Labs-Aetheron/Novexa/Documents/illustrations/Body/BotFrontImage1.jpg

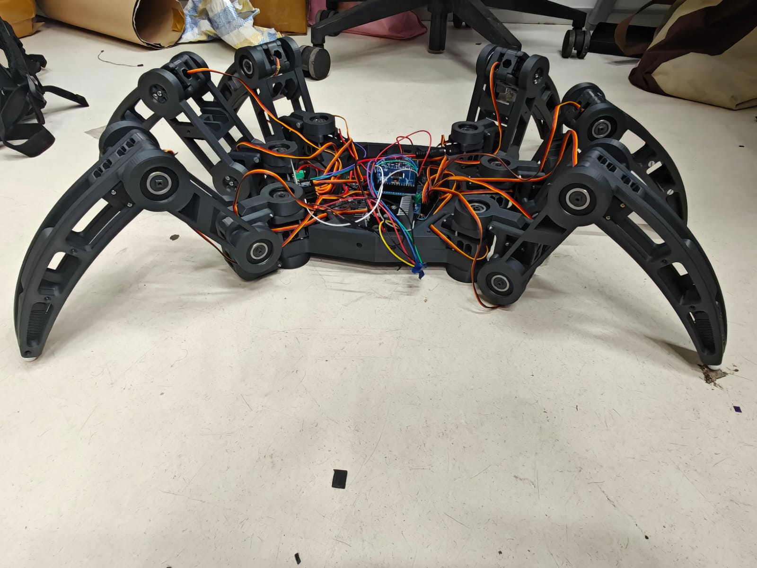
Documents/illustrations/Body/BotFrontImage1.jpg
