Labs-Aetheron/Novexa/Documents/BlockDiagram.jpg

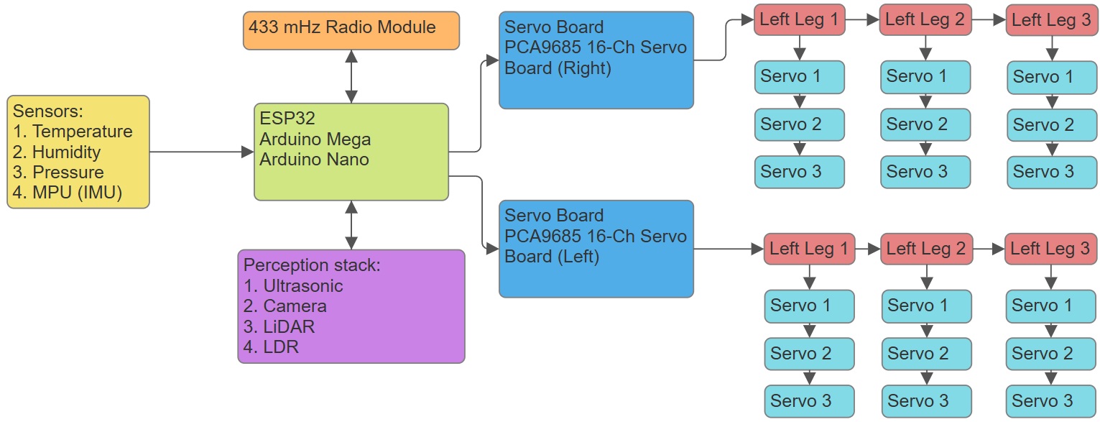
Documents/BlockDiagram.jpg
