Labs-Aetheron/Novexa/Documents/3D_Sketch.docx

1. Battery level Indicator:   Properties:

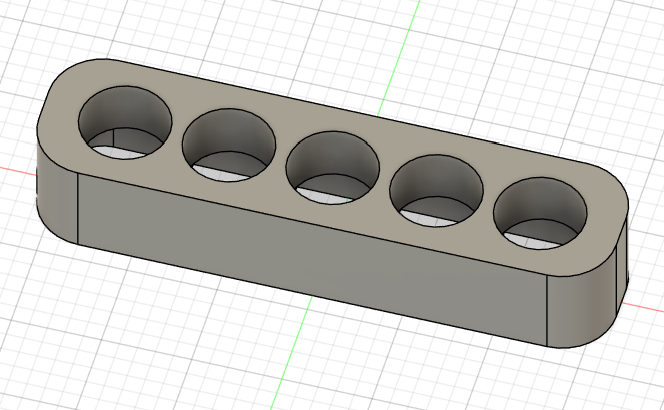
[picture p15: figure]
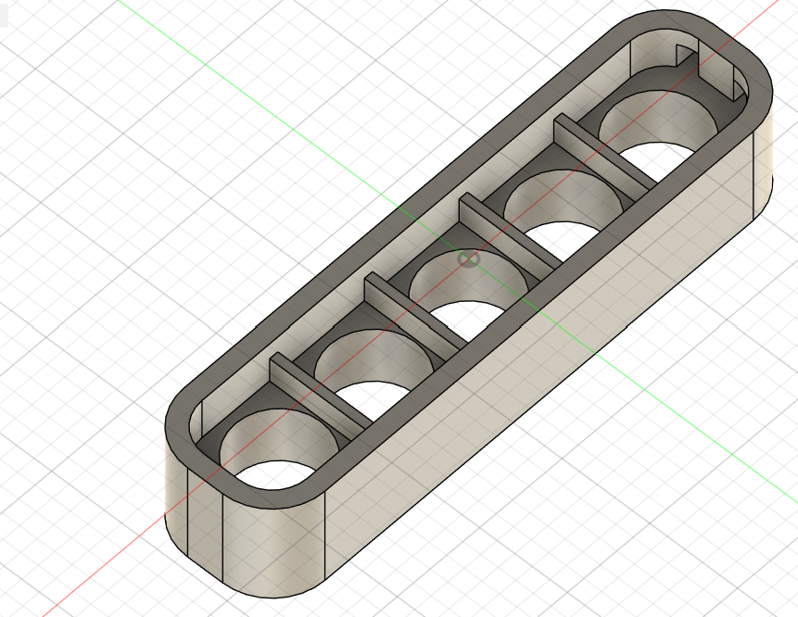
[picture p16: figure]
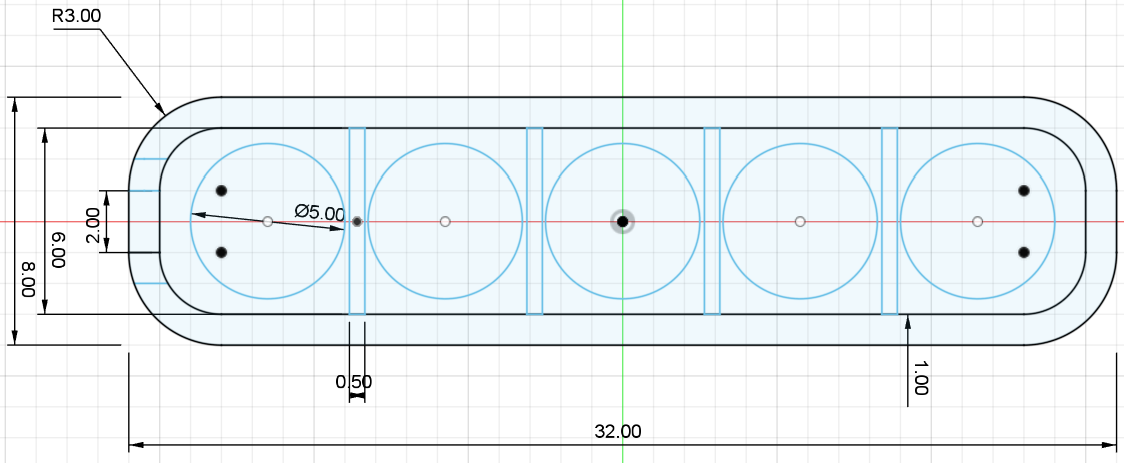
[picture p17: figure]

Area 1271.807 mm^2

Density 0.008 g / mm^3

Mass 5.648 g

Volume 719.527 mm^3

Bounding Box

Length 32.00 mm

Width 8.00 mm

Height 6.00 mm

2. 2S Battery Holder:   properties: Area 10756.48 mm^2

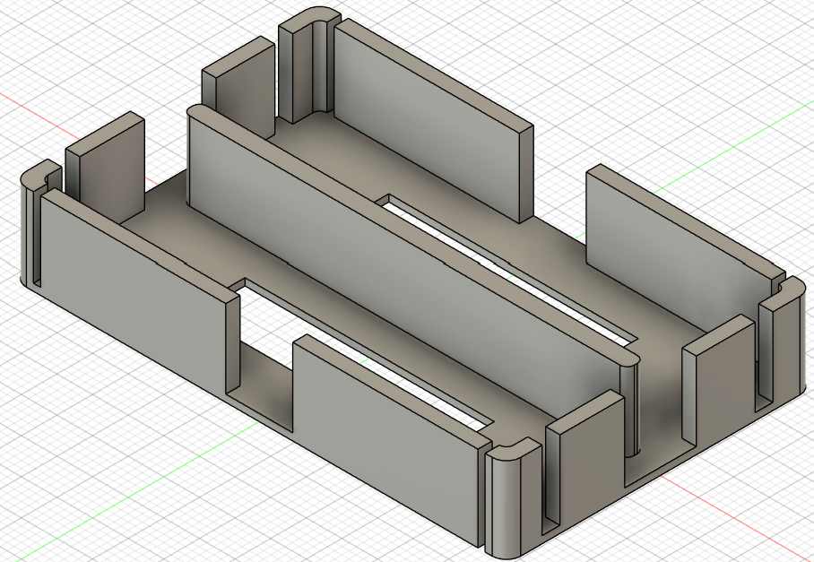
[picture p18: figure]
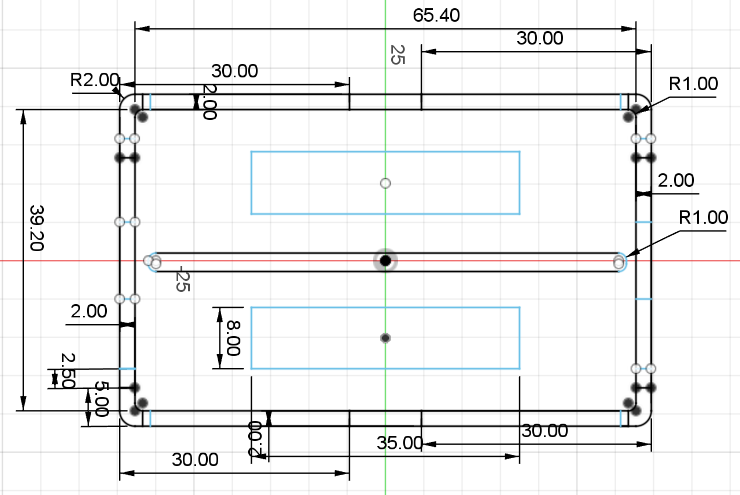
[picture p19: figure]

Mass 60.146 g

Volume 7661.88 mm^3

Bounding Box

Length 69.40 mm

Width 43.20 mm

Height 12.00 mm

3. Tibia Left/ Femur Right

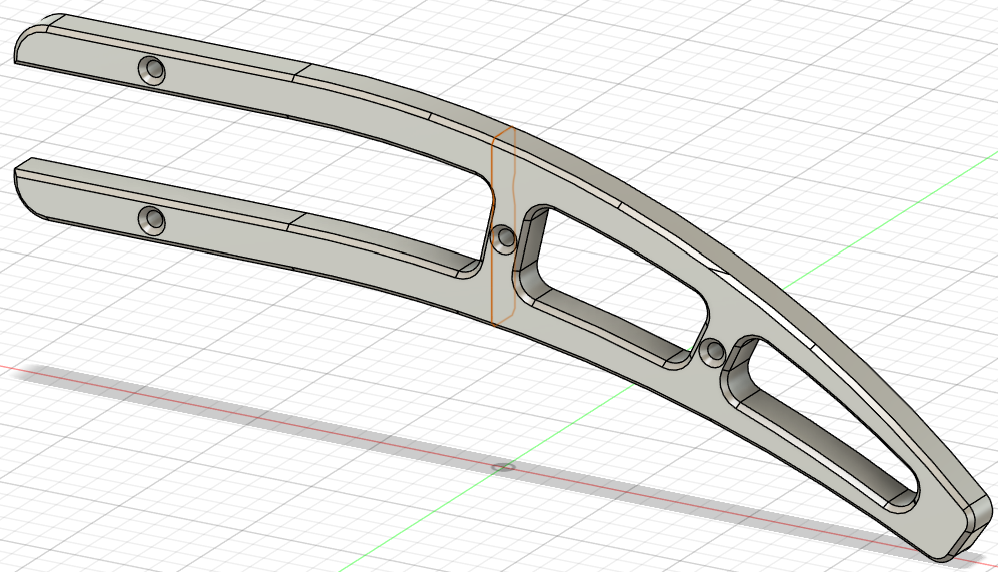
[picture p20: figure]
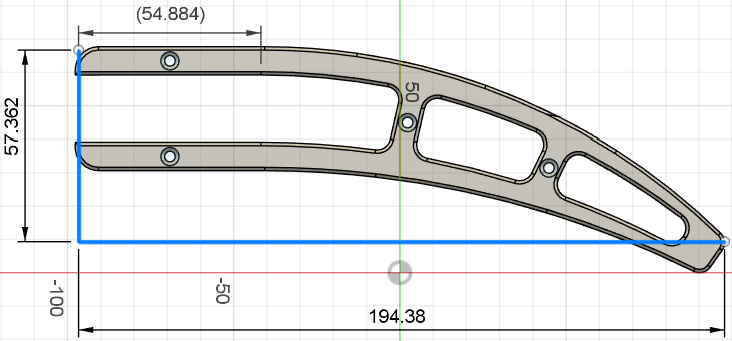
[picture p21: figure]

Properties:

Area 13073.055 mm^2

Mass 16.1747 g

Volume 26464.546 mm^3

Bounding Box

Length 195.402 mm

Width 8.30 mm

Height 67.695 mm

4. Tibia Support:

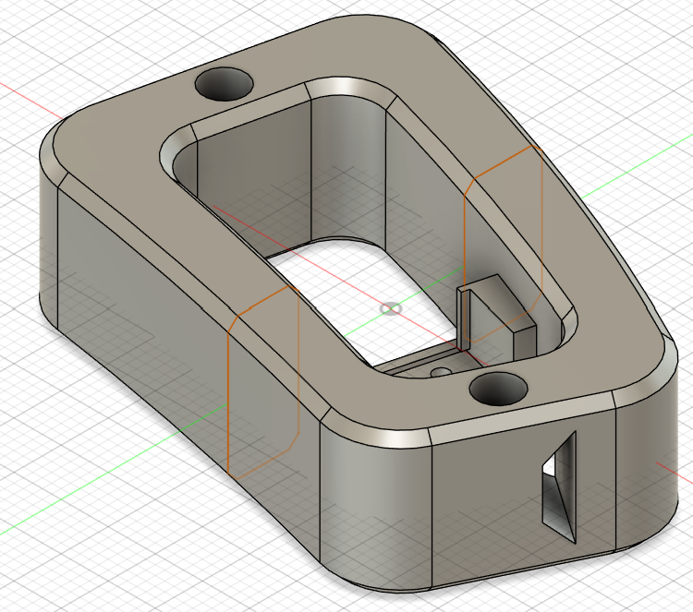
[picture p22: figure]
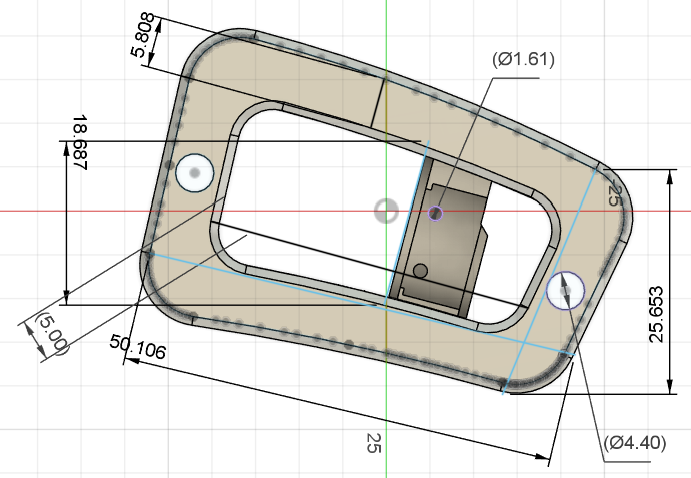
[picture p23: figure]

5. Tibia Suspension Left/Right:

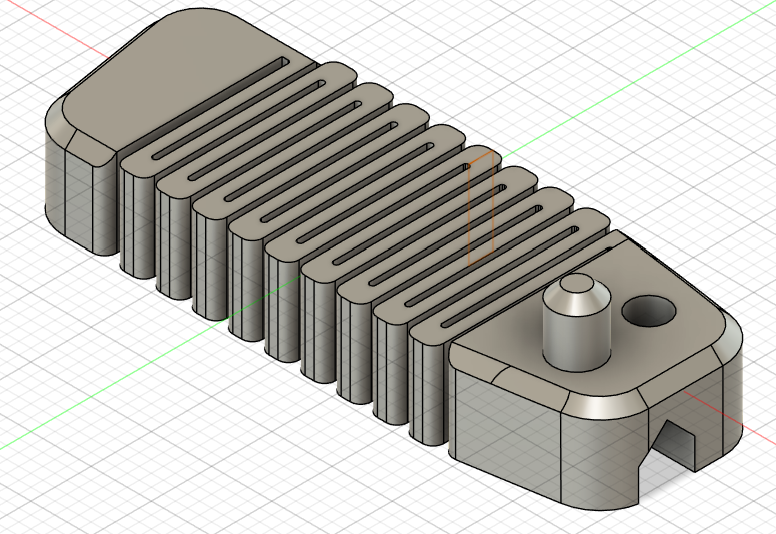
[picture p24: figure]
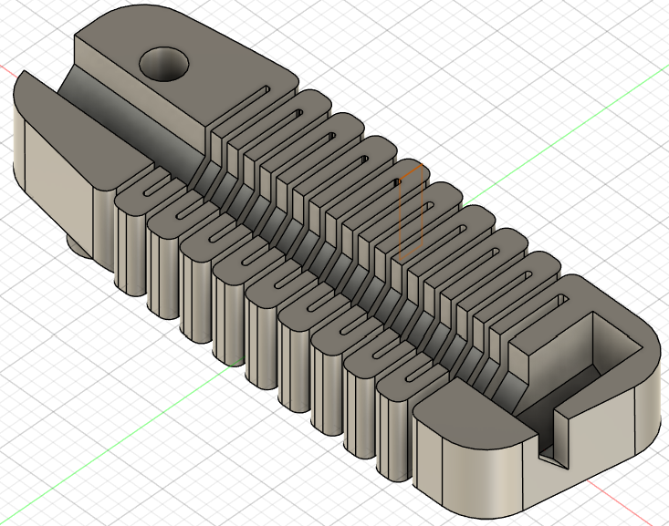
[picture p25: figure]
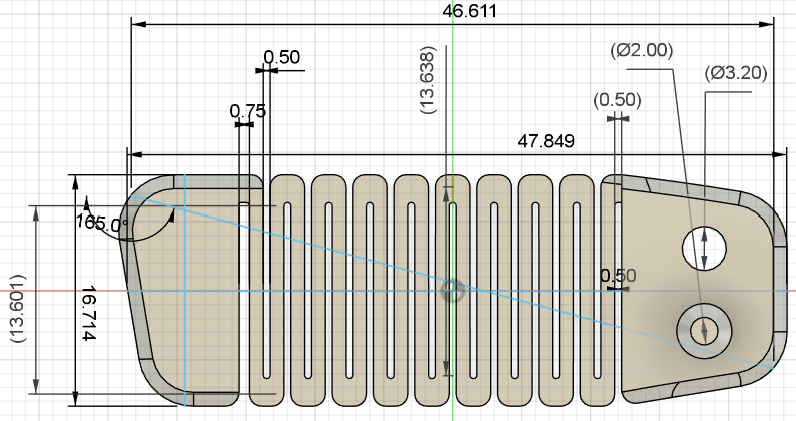
[picture p26: figure]

6. Tibia Shaft:

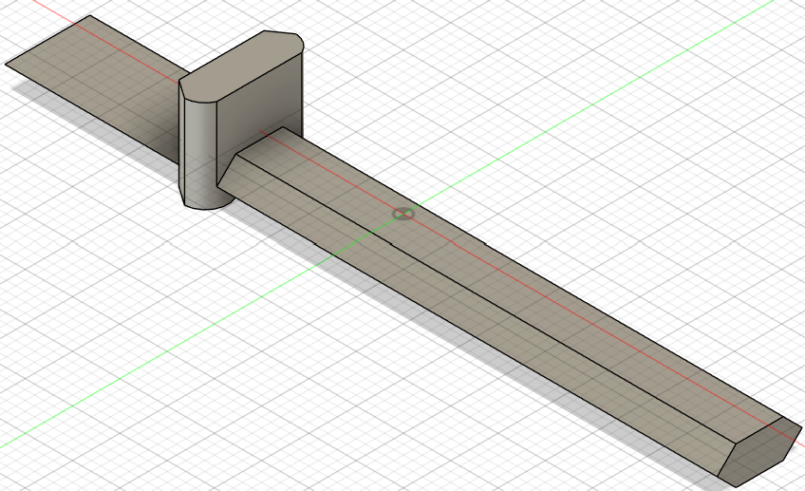
[picture p27: figure]
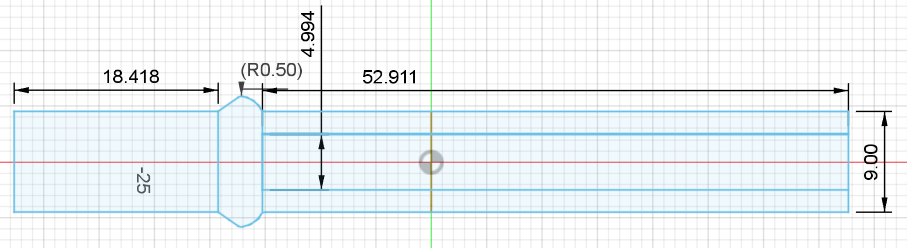
[picture p28: figure]

7. Tibia Tip:

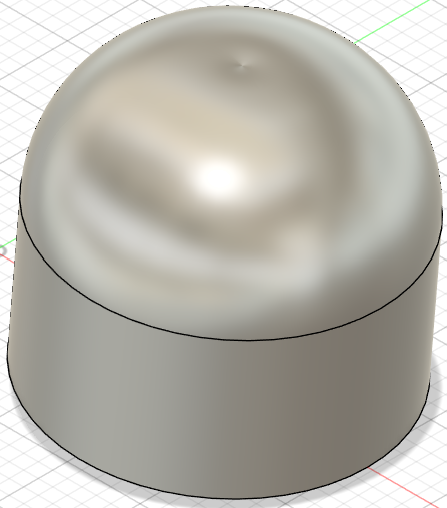
[picture p29: figure]
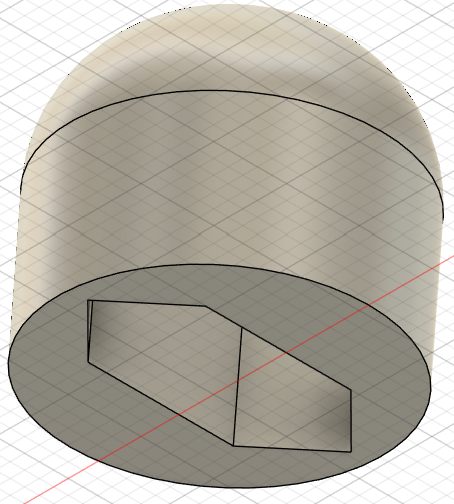
[picture p30: figure]
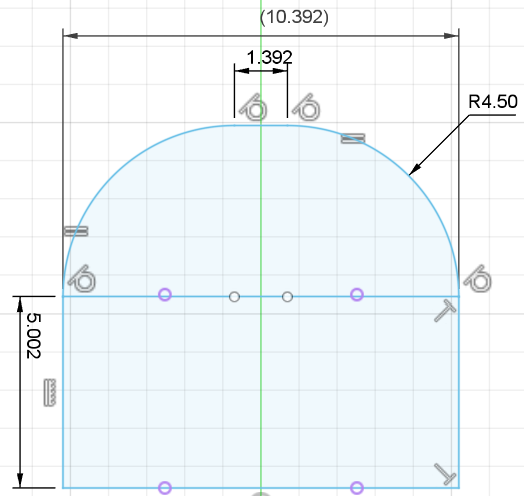
[picture p31: figure]

8. Femur Horn:

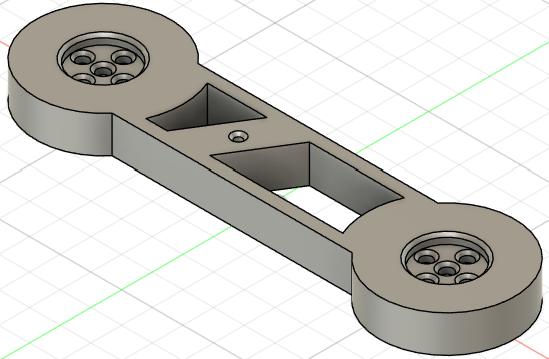
[picture p32: figure]
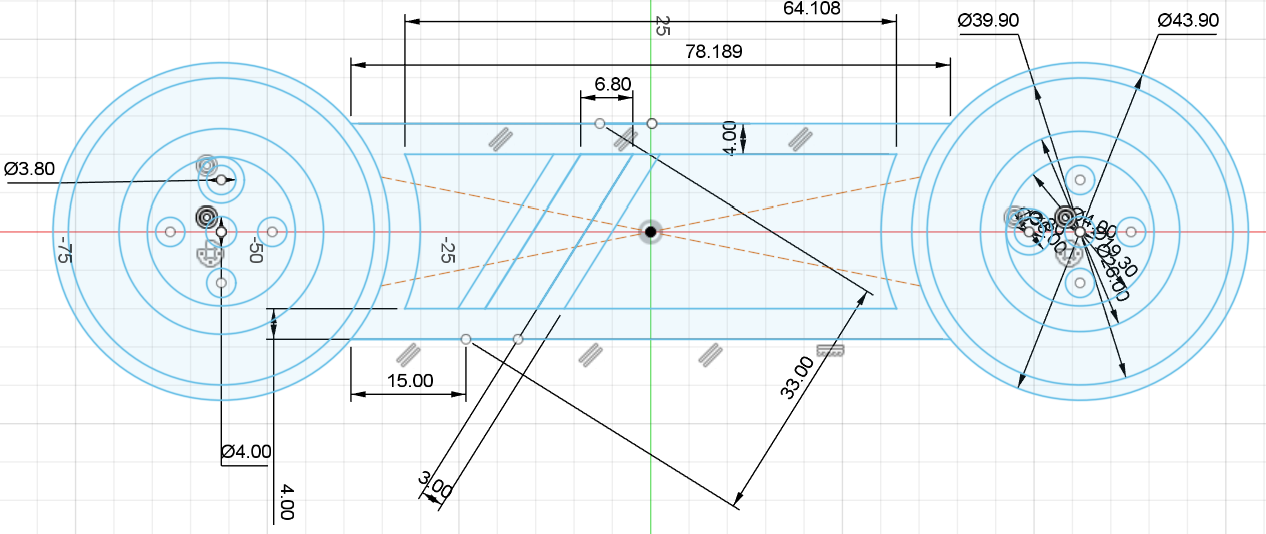
[picture p33: figure]

9. Femur Bearing:

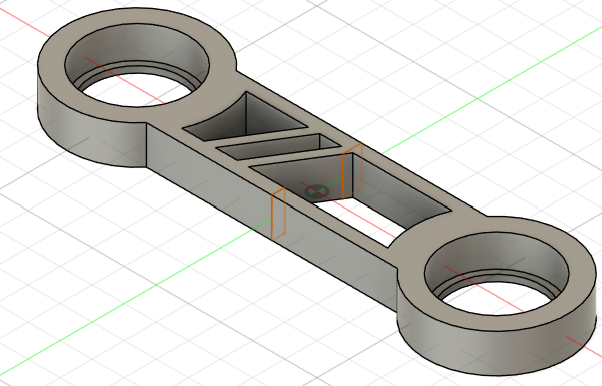
[picture p34: figure]
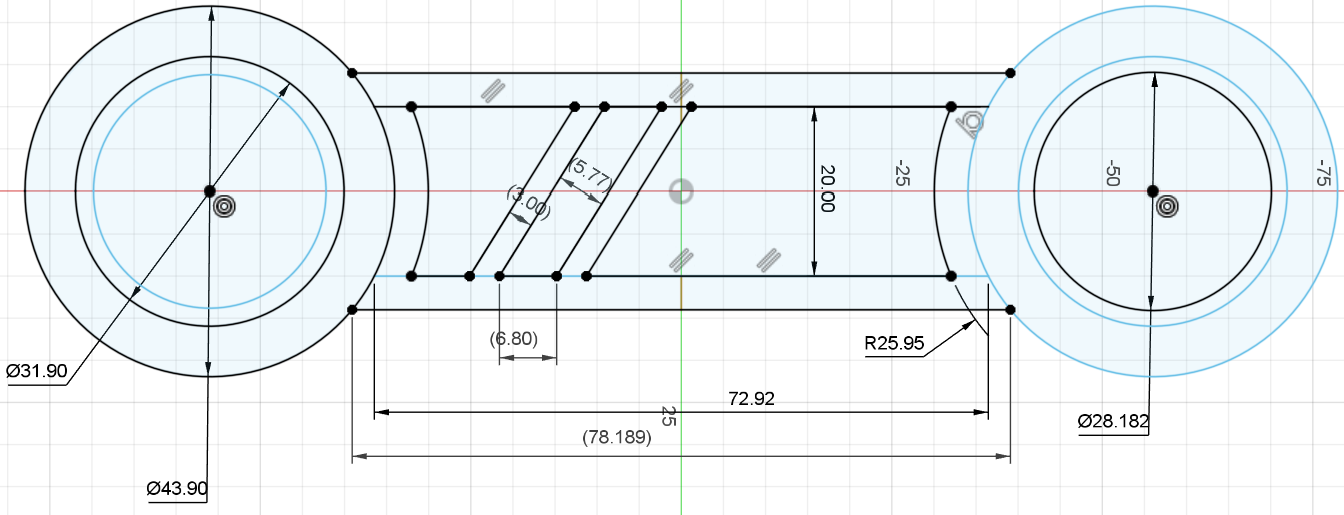
[picture p35: figure]

10. Femur Support:

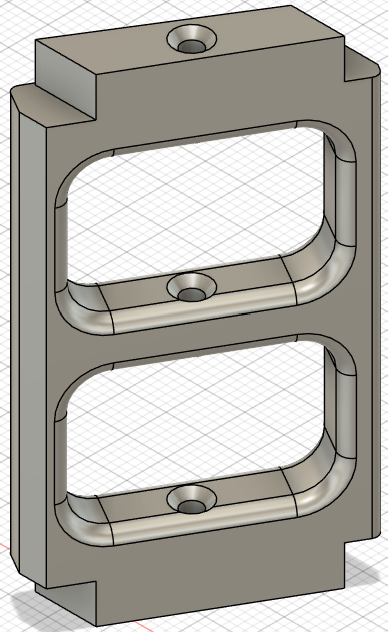
[picture p36: figure]
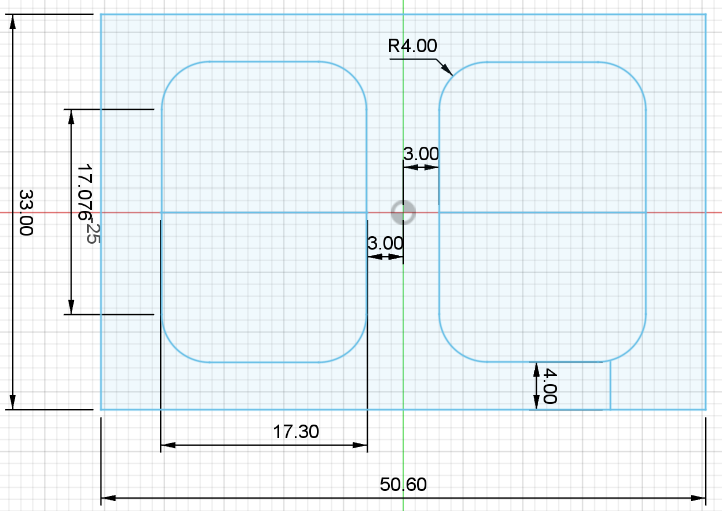
[picture p37: figure]

11. Coxa Horn/Bearing Side:

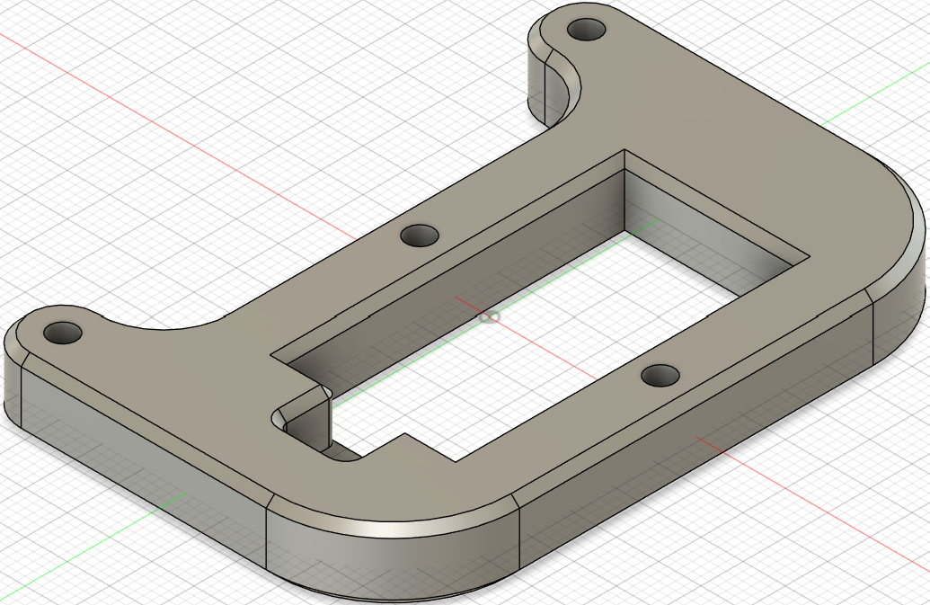
[picture p38: figure]
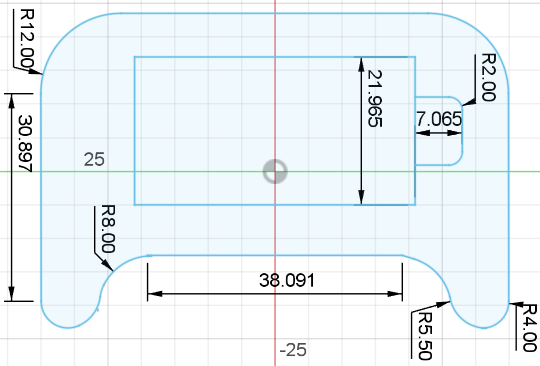
[picture p39: figure]

12. Coxa Horn Connector:

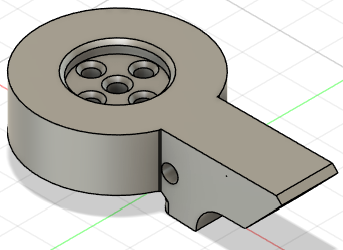
[picture p40: figure]
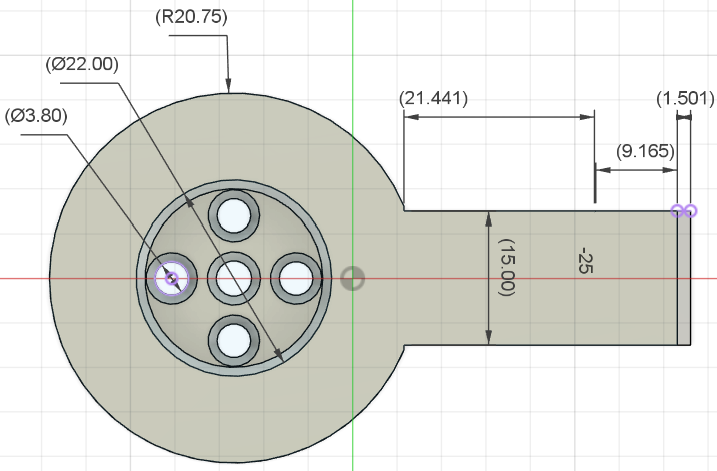
[picture p41: figure]

13. Coxa Bearing Connector:

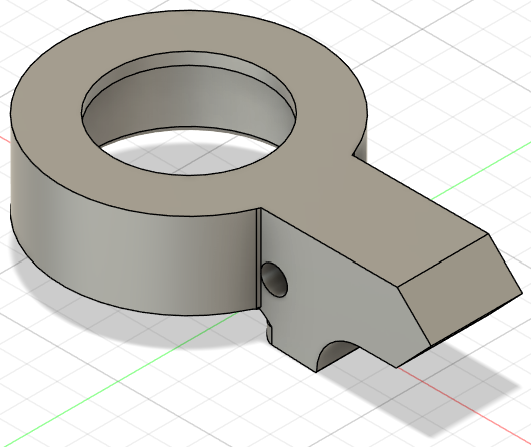
[picture p42: figure]
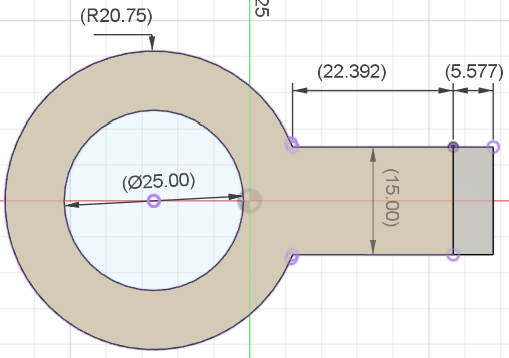
[picture p43: figure]

  a. Body Bottom Plate:
14. Body Mid:
15. Body Top:
