Labs-Aetheron/Novexa/Documents/illustrations/Body/BodyWithArms2.png

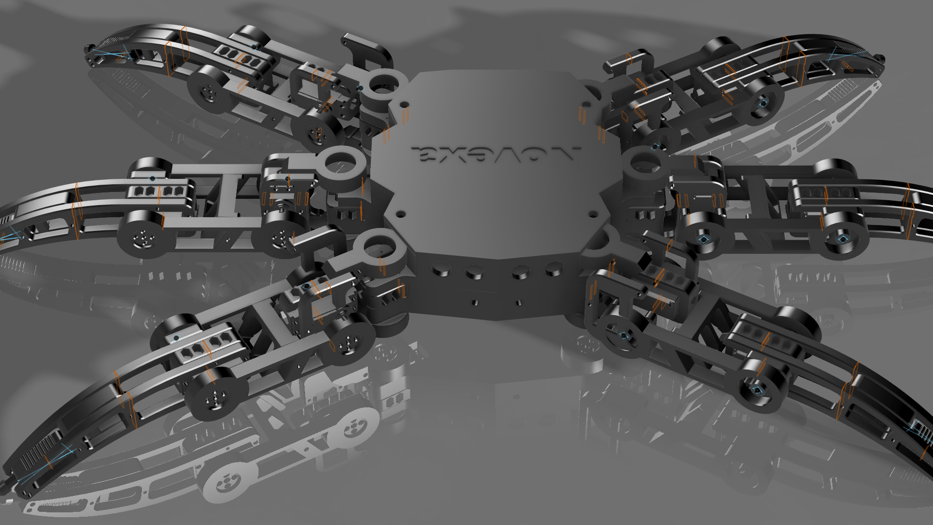
Documents/illustrations/Body/BodyWithArms2.png
