Labs-Aetheron/Novexa/Documents/illustrations/Body/BodyWithArms.jpg

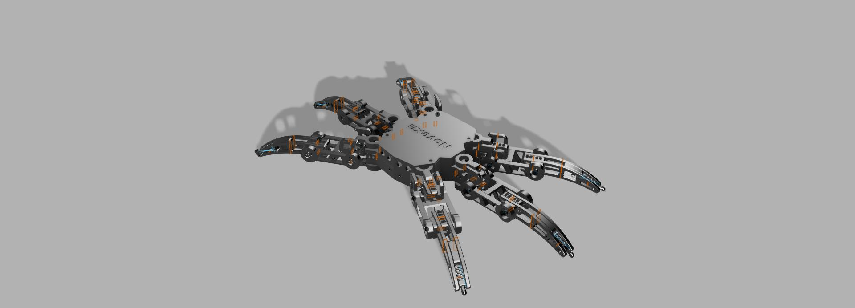
Documents/illustrations/Body/BodyWithArms.jpg
