Labs-Aetheron/Novexa/Documents/illustrations/Body/BodyWithArms.png

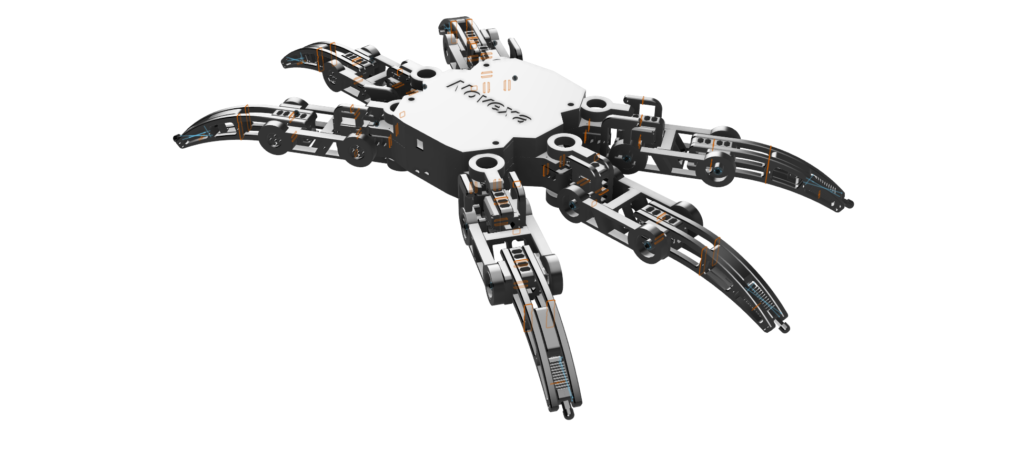
Documents/illustrations/Body/BodyWithArms.png
