Labs-Aetheron/Novexa/Documents/illustrations/Body/Display for Public Visit.png

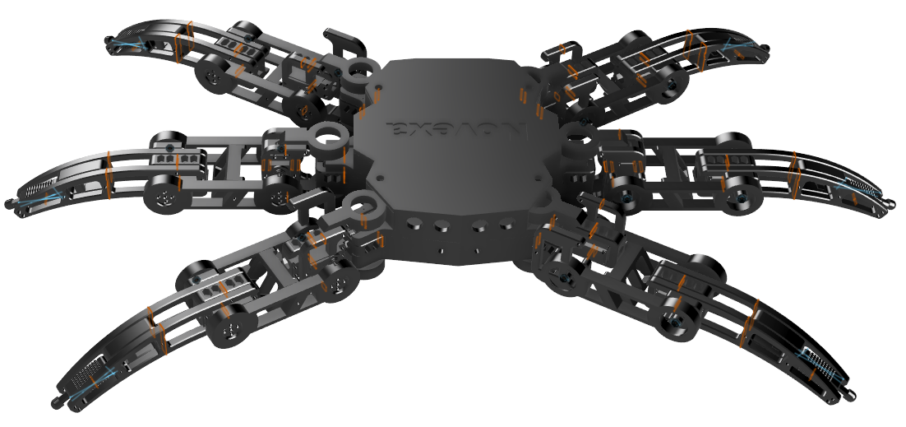
Documents/illustrations/Body/Display for Public Visit.png
