Labs-Aetheron/Novexa/Documents/illustrations/BodyWithArms.png

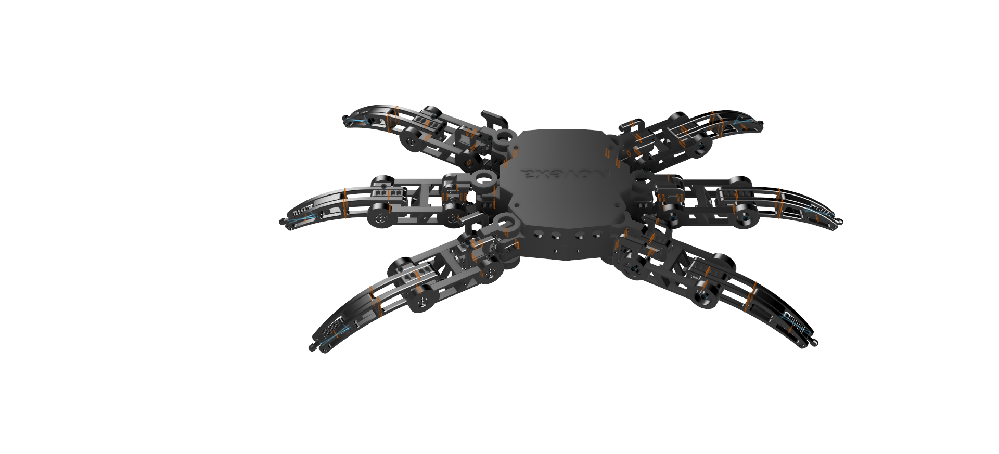
Documents/illustrations/BodyWithArms.png
