Labs-Aetheron/Novexa/Documents/Component_List.xlsx

Sheet: Robu.in Purchases
Sr | Component | Qty | Unit Price (₹) | Specification / Model | Function / Requirement | Suitability / Comment | Total (₹)
1 | RF Transmitter Receiver Module 433MHz Wireless Link Kit For Arduino | 1 | ₹84.00 | 433 MHz Link Kit | Remote control communication | Works perfectly for basic wireless rover control | ₹84.00
2 | 15CM SMA Female to IPEX4 Connector Cable 11mm RG0.81 | 2 | ₹94.00 | RG0.81, 15 cm | Antenna pigtails for TX/RX | Proper impedance for 433 MHz RF; one for TX, one for RX | ₹188.00
3 | 2S 5A 8.4V 18650 Lithium Battery Charger Board Protection Module | 1 | ₹54.00 | 2S Charger (may include protection) | Charge logic 2S pack | OK; verify overlap with 2S BMS | ₹54.00
4 | PDC004-PD PD Decoy Module 12V | 1 | ₹117.00 | USB‑C PD trigger (12 V) | Single‑port charging hub | Excellent choice, 60 W PD sink | ₹117.00
5 | 4S 16.8V 2A 18650 Lithium Battery Charger Module Type C | 1 | ₹117.00 | 4S charger | Charge servo 4S pack | Check VIN range (5–12 V) | ₹117.00
6 | 4 Series 40A 18650 Lithium Battery Protection Board | 1 | ₹138.00 | 4S 14.8–16.8 V with balance | Servo pack protection | Correct for high-current pack | ₹138.00
7 | 2S 10A 18650 Battery Protection Board | 1 | ₹95.00 | 2S 7.4–8.4 V | Logic pack protection | Suitable for Arduino/sensors | ₹95.00
8 | Littelfuse MAXI 0299040 40 A Fuse | 2 | ₹90.00 | MAXI 299, 32 V | Main 4S line fuse | Industrial-grade protection | ₹180.00
9 | 5×20 mm Glass Fuse 10 A | 5 | ₹6.00 | Glass Fuse 10 A | Secondary protection (logic/charger lines) | Simple protection | ₹30.00
10 | Toggle Switch KNX‑209 | 1 | ₹52.00 | SPST | Remote power | Use in handheld remote | ₹52.00
11 | KCD2‑201 DPST Rocker Switch (ON‑OFF) | 1 | ₹68.00 | DPST 4‑pin | Master switch (4S + 2S) | Ideal dual-battery control | ₹68.00
12 | Mini MP1584 DC‑DC 3 A Adjustable Buck Module | 2 | ₹39.00 | MP1584 3 A | 5 V logic rail | Efficient small buck for Arduino; one spare | ₹78.00
13 | 200 W 20 A CC/CV Buck Converter | 2 | ₹369.00 | 6–40 V → adj; CC/CV | 5.8 V servo rails (two bucks) | Good current & thermal headroom | ₹738.00
14 | 4700 µF 50 V Electrolytic Capacitor | 4 | ₹53.00 | 50 V bulk cap | Servo rail surge buffer | Prevents voltage dips when servos spike | ₹212.00
15 | 0.1 µF Ceramic Capacitor SMD 1206 | 8 | ₹1.38 | 100 nF | HF decoupling at buck outputs | Filters switching noise | ₹11.04
16 | SMBJ6.8CA TVS Diode | 2 | ₹6.00 | 6.8 V bidirectional 600 W | Clamp servo rail spikes | Protects buck from back-EMF | ₹12.00
17 | Rubycon 220 µF 10 V (10YXJ220M5X11) | 6 | ₹7.00 | Low‑ESR 10 V | Logic buck smoothing | Top quality, high ripple tolerance | ₹42.00
18 | Male‑Male Jumper Wires 20 cm (40 pcs) | 1 | ₹42.00 | Dupont 20 cm | Signals / prototyping | Useful for testing | ₹42.00
19 | Male‑Female Jumper Wires 10 cm (40 pcs) | 1 | ₹35.00 | Dupont 10 cm | Logic interconnect | Standard Arduino links | ₹35.00
20 | Amass XT60I‑F.G.O Female Connector | 4 | ₹61.00 | XT60 30 A+ | Battery/rail connectors | Reliable gold‑plated terminals | ₹244.00
21 | Nickel Strip 0.1 × 4 × 100 mm (50 pcs) | 1 | ₹153.00 | Pure nickel | Cell interconnects | Optional; helps in pack build | ₹153.00
Total: |  | 48 | ₹1681.38 |  |  |  | ₹2690.04

Sheet: Lamington Road
Sr | Component | Qty | Unit Price (₹) | Specification / Model | Function / Requirement | Suitability / Comment | Total (₹)
1 | MG995 Servo Motor | 20 | ₹225.00 | ≈9 kg·cm | Actuators (18 used + 2 spare) | Perfect for hexapod legs | ₹4500.00
2 | Joystick Module | 3 | ₹40.00 | Analog dual‑axis | Remote input | Ideal for handheld remote | ₹120.00
3 | PCA9685 16‑Ch Servo Board | 2 | ₹275.00 | 16‑ch PWM | Servo signal driver | Required (2 boards total) | ₹550.00
4 | Arduino Mega 2560 | 1 | ₹1000.00 | Main MCU | Robot control | Excellent for many I/O | ₹1000.00
5 | Arduino Nano | 1 | ₹250.00 | ATmega328 | Remote / aux control | Good secondary MCU | ₹250.00
6 | MPU6050 IMU | 1 | ₹175.00 | 6‑axis | Stability sensing | Good for balance | ₹175.00
7 | Arduino Nano USB Cable | 1 | ₹20.00 | USB | Programming Nano | Required connectivity | ₹20.00
8 | Resistors (assorted) | 12 | ₹1.00 | ¼ W | LEDs / dividers | Basic electronics need | ₹12.00
9 | Switches (misc) | 2 | ₹5.00 | Mini toggle | Misc toggling | Standard | ₹10.00
10 | 18650 Li‑ion Cells | 8 | ₹65.00 | 3.7 V 2600 mAh | Batteries for packs | Right capacity class | ₹520.00
11 | Wire stripper | 1 | ₹450.00 | Tool | Assembly | Essential tool | ₹450.00
12 | Screw & Nut pack (50 pcs) | 1 | ₹140.00 | Assortment | Frame and mounts | Useful hardware | ₹140.00
13 | Soldering wire | 1 | ₹120.00 | Flux core | Assembly | Required for wiring | ₹120.00
14 | Bearings | 18 | ₹35.00 | 32.00 mm | To make the arm frictionless | 32 mm bearings reduce friction in limb joints, improving motion precision and protecting servos for longer life. | ₹630.00
15 | Copper wire (4 m) | 1 | ₹40.00 | Bare copper | Low‑current | Not for high current | ₹40.00
Total: |  | 73 | ₹2841.00 |  |  |  | ₹8537.00

Sheet: Overall Evaluation
Aspect | Comment
Power architecture | Dual-battery (4S servos, 2S logic) with separate bucks; clean, stable; single USB‑C input charges both packs.
Protection | BMS on both packs, main 40 A fuse, logic fuses, bulk caps + ceramic + TVS; robust against shorts and surges.
Servo supply | Two 20 A CC/CV bucks (one per PCA board) set to ~5.8 V; good thermal headroom with fans.
Logic supply | MP1584 set to 5.00 V; low‑ESR 220 µF + 0.1 µF at output; powers Arduino + PCA logic reliably.
Grounding | Common star ground between servo and logic rails; prevents signal reference issues.
Wiring | Use silicone multi‑strand; correct gauge selection prevents drops/heating; XT60 connectors for reliability.
Charging | PD decoy → 4S & 2S chargers; chargers wired directly to BMS P+/P− via small fuses; master switch OFF when charging.
Scalability | Two rails and PCA stack make expansion easy; spares included (extra MP1584).

Sheet: Summary
Source | Total (₹)
Robu.in | ₹2690.04
Lamington Road | ₹8537.00
Grand Total (Purchased) | ₹11227.04
