Labs-Aetheron/Novexa/Mechanical/Design/Assembly/novexa_assembly_01.step

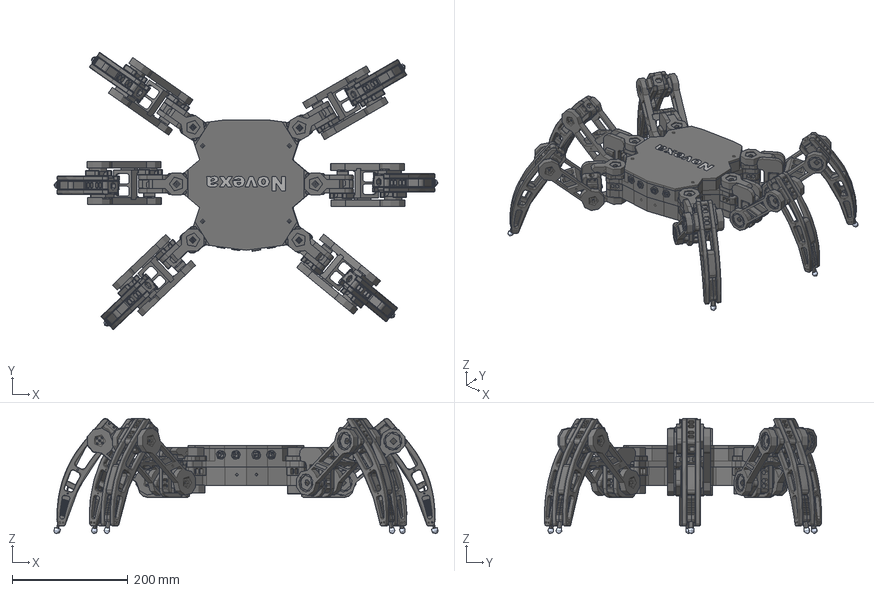
[picture p51: CAD file, 2026-10-25]
Mechanical/Design/Assembly/novexa_assembly_01.step
662.5 x 477.8 x 198.7 mm
ArduinoMega_STEP_AP203
PCB x 2
Case Cover x 4
T-R Case x 4
T-R Core x 4
T-R Terminal x 8
Crystal x 2
90deg_pin x 8
Conn_1X4_case x 2
SOP14_TPK x 4
16-SOIC x 2
