Labs-Aetheron/Novexa/Mechanical/Design/All STLS/BearingMountV3.stl

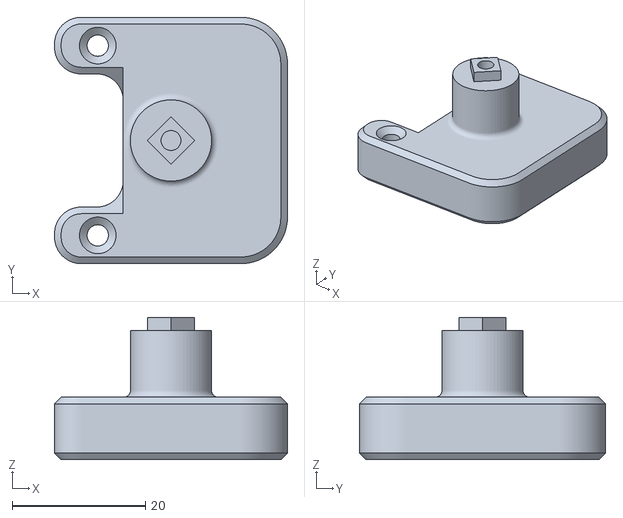
[picture p52: CAD file, 2025-12-05]
Mechanical/Design/All STLS/BearingMountV3.stl
35.0 x 37.0 x 21.4
