Labs-Aetheron/Novexa/Mechanical/Design/All STLS/Print/BilalSabugar_FinalBuildParts_BTechRoboticsFY.3mf

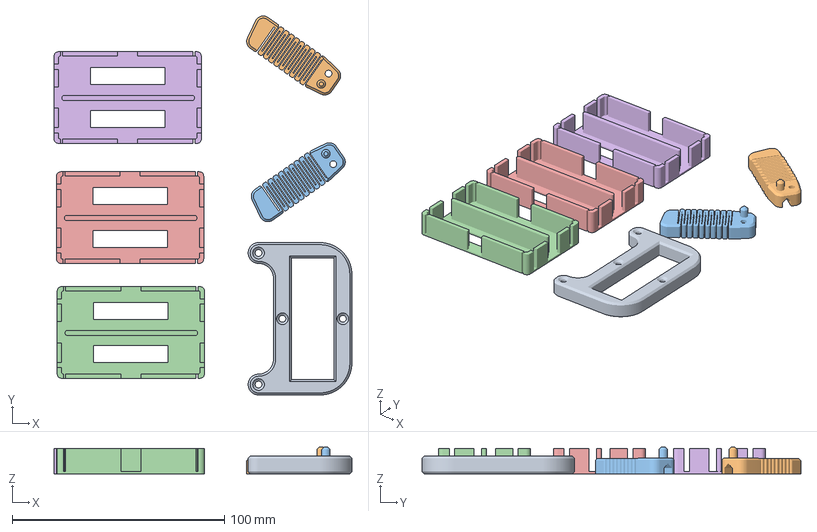
[picture p53: CAD file, 2025-12-05]
Mechanical/Design/All STLS/Print/BilalSabugar_FinalBuildParts_BTechRoboticsFY.3mf
140.4 x 178.6 x 12.5 mm
Coxa Horn Side.stl
Foot Left.stl
Foot Right.stl
2SBatteryHolder.stl x 3
