Labs-Aetheron/Novexa/Mechanical/Design/Cad/BilalSabugar_CrabyyPartsV2_BTechRoboticsFY.stl

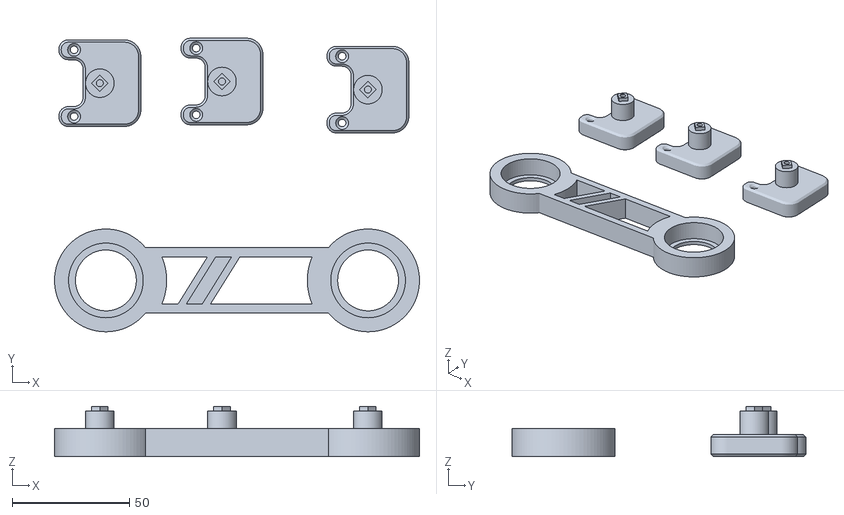
[picture p54: CAD file, 2025-12-05]
Mechanical/Design/Cad/BilalSabugar_CrabyyPartsV2_BTechRoboticsFY.stl
155.9 x 125.4 x 21.4
