Labs-Aetheron/Novexa/Mechanical/Design/All STLS/BottomPlateV2.stl

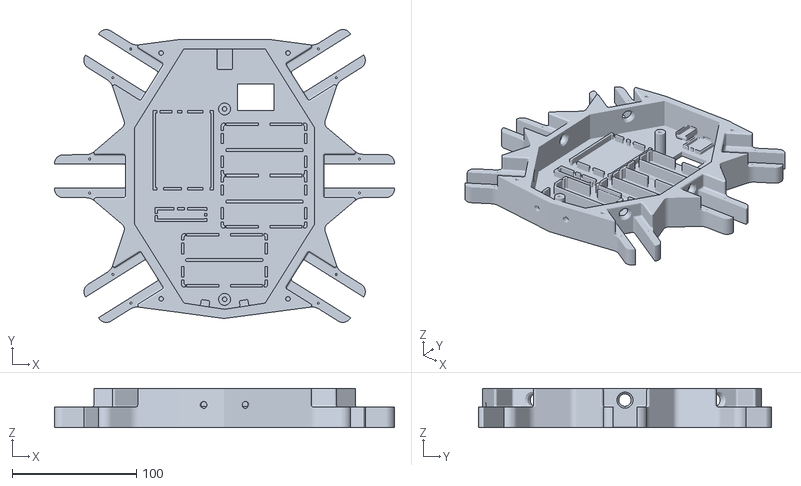
[picture p55: CAD file, 2025-12-05]
Mechanical/Design/All STLS/BottomPlateV2.stl
274.2 x 236.2 x 31.7
