Labs-Aetheron/Novexa/Mechanical/Design/All STLS/Print/BilalSabugar_ServoMount_BTechRoboticsFY.3mf

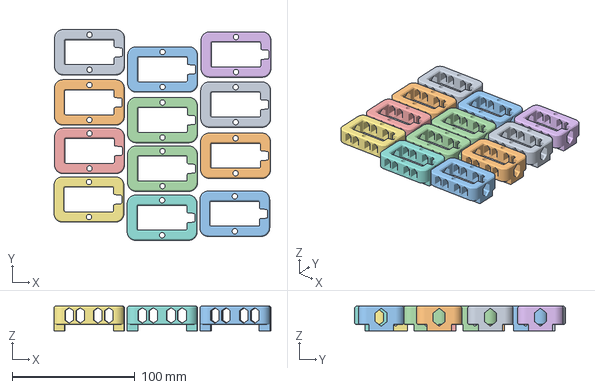
[picture p56: CAD file, 2025-12-05]
Mechanical/Design/All STLS/Print/BilalSabugar_ServoMount_BTechRoboticsFY.3mf
176.8 x 171.8 x 20.0 mm
Servo Mount.stl x 12
