Labs-Aetheron/Novexa/Mechanical/Design/All STLS/BodyCoverV2.stl

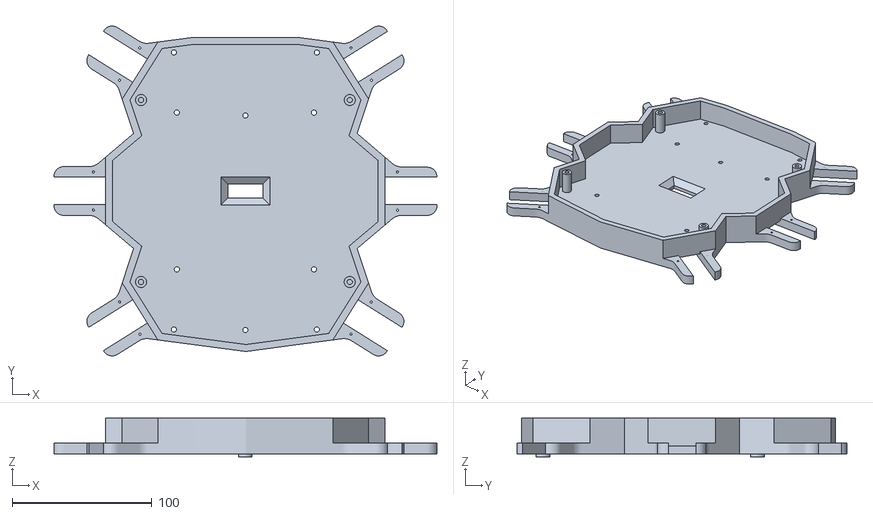
[picture p57: CAD file, 2025-12-05]
Mechanical/Design/All STLS/BodyCoverV2.stl
274.2 x 236.1 x 27.9
