Labs-Aetheron/Novexa/Mechanical/Design/All STLS/Print/BearingMountV2Extras.3mf

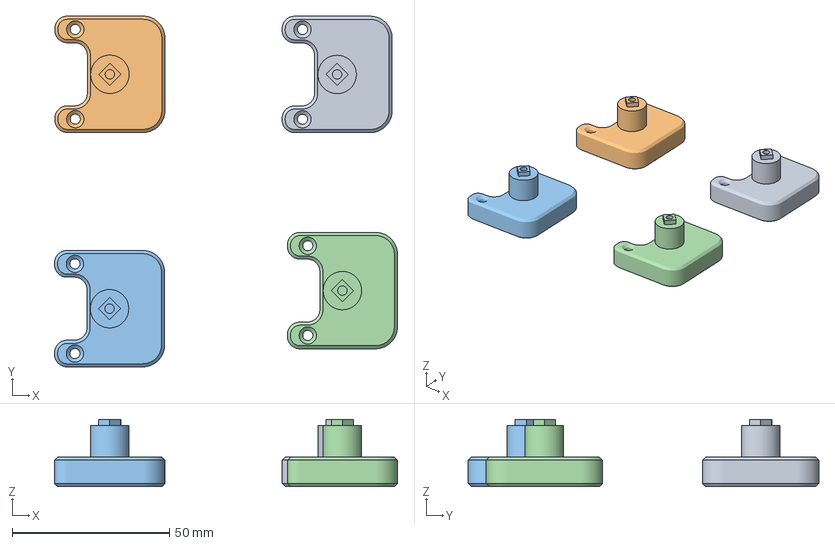
[picture p58: CAD file, 2025-12-05]
Mechanical/Design/All STLS/Print/BearingMountV2Extras.3mf
109.0 x 111.5 x 21.4 mm
BearingMountV2.stl x 4
