Labs-Aetheron/Novexa/Mechanical/Design/Cad/FemurBearingSideV2.stl

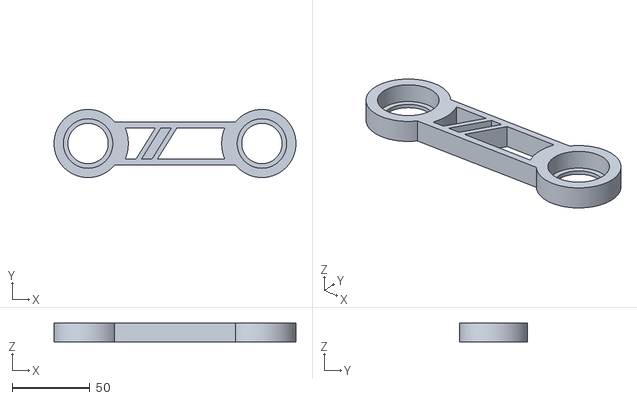
[picture p59: CAD file, 2025-12-05]
Mechanical/Design/Cad/FemurBearingSideV2.stl
155.9 x 43.9 x 12.0
