Labs-Aetheron/Novexa/Mechanical/Design/All STLS/CoxaBearingConnectorV2.stl

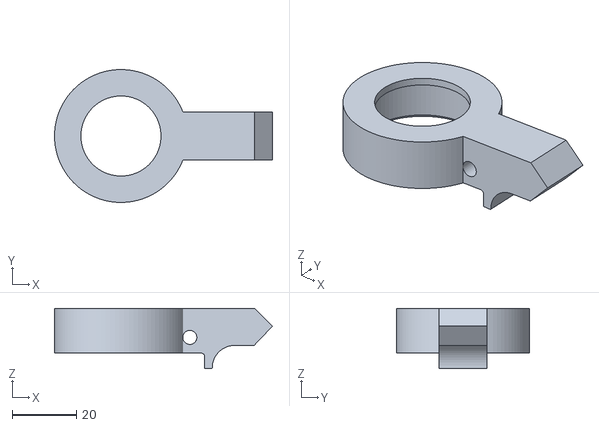
[picture p60: CAD file, 2025-12-05]
Mechanical/Design/All STLS/CoxaBearingConnectorV2.stl
68.1 x 41.5 x 18.8
