Labs-Aetheron/Novexa/Mechanical/Design/All STLS/Print/BilalSabugar_Prototype3_BTechRoboticsFY.3mf

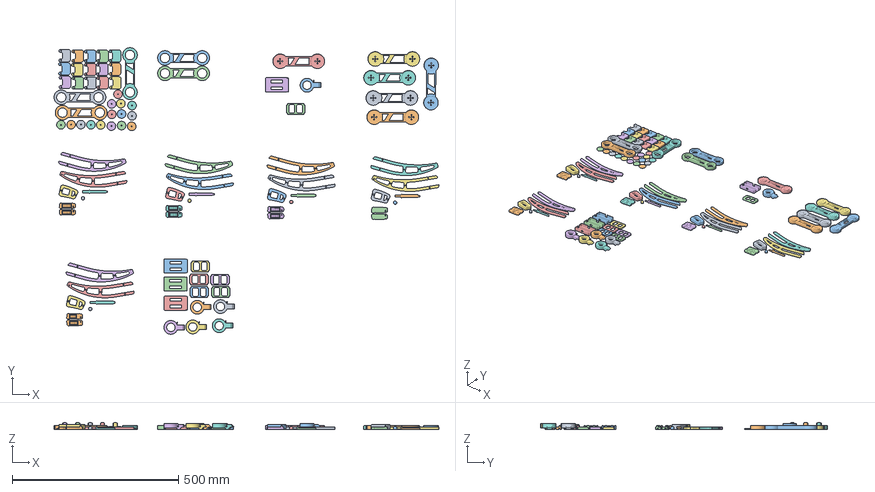
[picture p61: CAD file, 2025-12-05]
Mechanical/Design/All STLS/Print/BilalSabugar_Prototype3_BTechRoboticsFY.3mf
1156.8 x 861.1 x 21.4 mm
BearingMountV2.stl x 15
FemurBearingSideV2.stl x 5
FemurHornSideV2.stl x 6
2SBatteryHolder.stl x 4
Hubcap.stl x 15
CoxaBearingConnectorV2.stl x 6
FemurSupportV2.stl x 6
Tibia Left.stl x 5
Tibia Right.stl x 5
Tibia Support.stl x 5
Foot Shaft.stl x 5
Foot Tip.stl x 5
Foot Left Right.stl x 5
