Labs-Aetheron/Novexa/Mechanical/Design/All STLS/Print/BilalSabugar_PrototypeTwo_BTechRoboticsFY.3mf

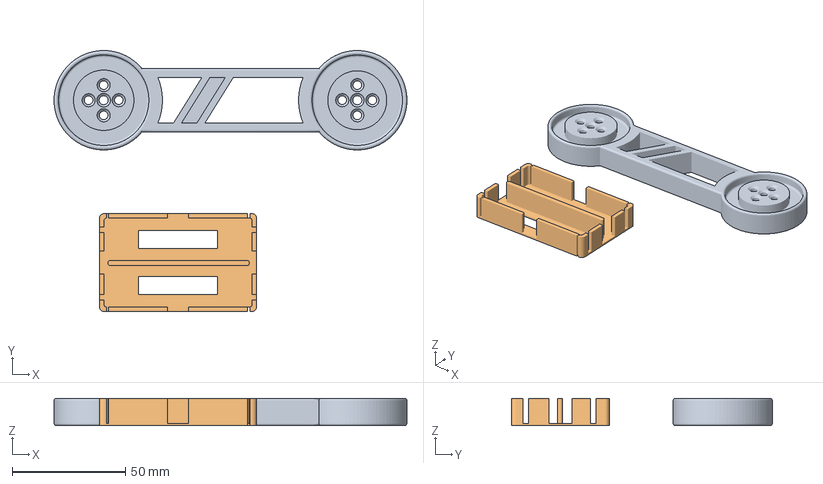
[picture p62: CAD file, 2025-12-05]
Mechanical/Design/All STLS/Print/BilalSabugar_PrototypeTwo_BTechRoboticsFY.3mf
155.9 x 115.2 x 12.0 mm
FemurHornSideV2.stl
2SBatteryHolder.stl
