Labs-Aetheron/Novexa/Mechanical/Design/All STLS/BodyWithArms.stl

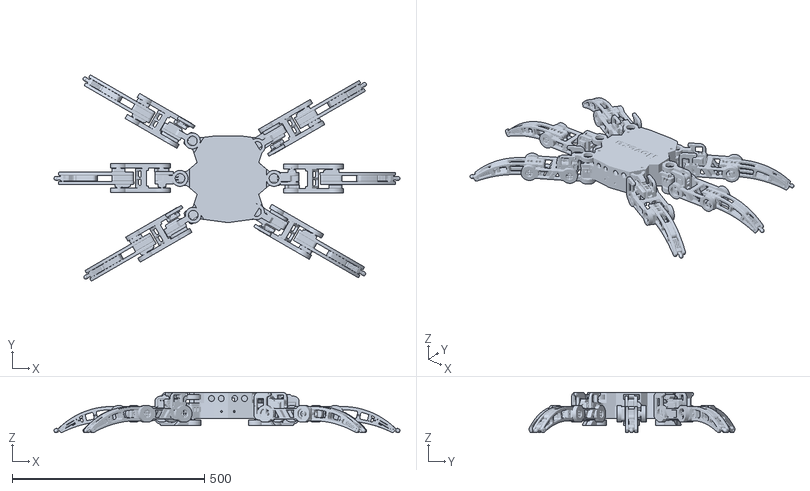
[picture p63: CAD file, 2025-12-05]
Mechanical/Design/All STLS/BodyWithArms.stl
899.2 x 535.6 x 105.2
