Labs-Aetheron/Novexa/Mechanical/Design/All STLS/Print/BilalSabugar_MiddlePlateV2_BTechRoboticsFY.stl

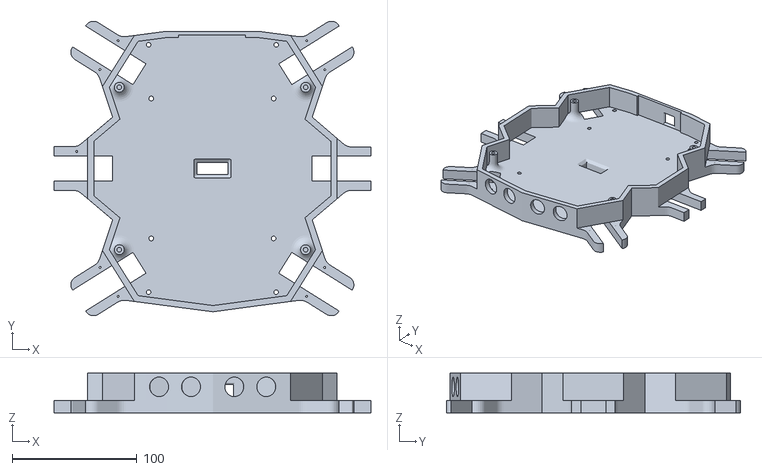
[picture p64: CAD file, 2025-12-05]
Mechanical/Design/All STLS/Print/BilalSabugar_MiddlePlateV2_BTechRoboticsFY.stl
254.2 x 236.1 x 31.9
