Labs-Aetheron/Novexa/Mechanical/Design/All STLS/FemurSupportV2.stl

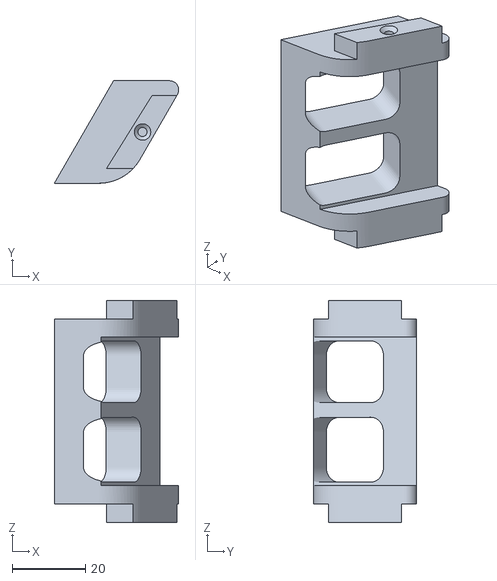
[picture p65: CAD file, 2025-12-05]
Mechanical/Design/All STLS/FemurSupportV2.stl
34.0 x 28.0 x 60.6
