Labs-Aetheron/Novexa/Mechanical/Design/All STLS/Print/BilalSabugar_FemurPrototypeV2_BTechRoboticsFY.3mf

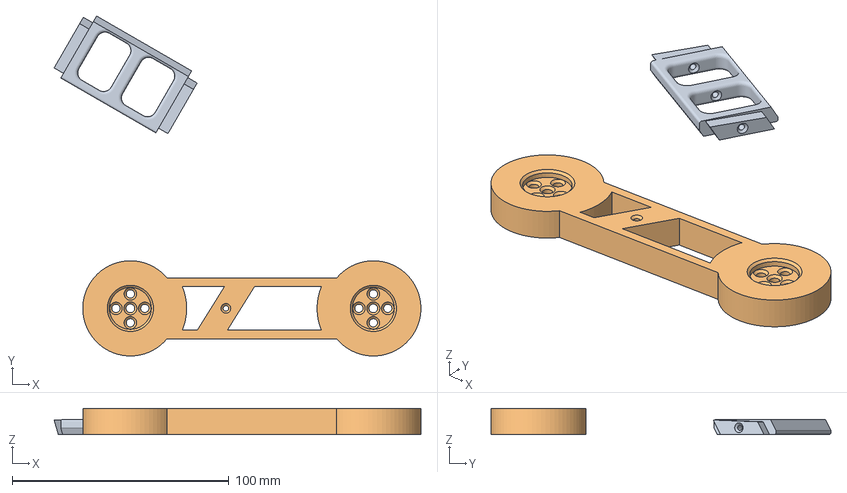
[picture p66: CAD file, 2025-12-05]
Mechanical/Design/All STLS/Print/BilalSabugar_FemurPrototypeV2_BTechRoboticsFY.3mf
169.1 x 156.7 x 12.0 mm
FemurSupportV2.stl
FemurHornSideV2.stl
