Labs-Aetheron/Novexa/Mechanical/Design/All STLS/BodyTopCover.stl

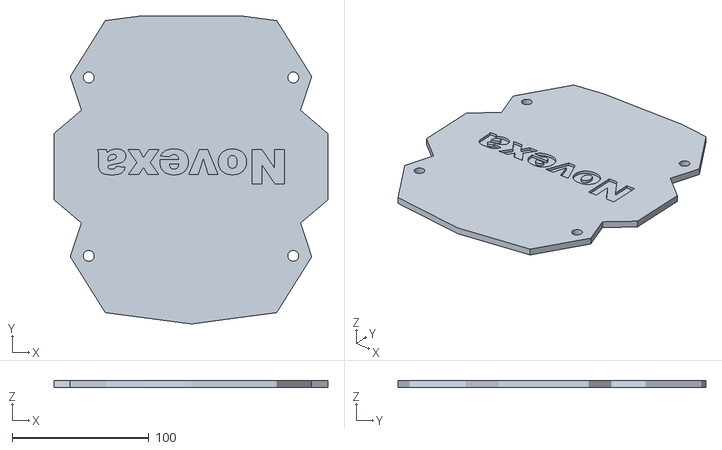
[picture p67: CAD file, 2025-12-05]
Mechanical/Design/All STLS/BodyTopCover.stl
200.0 x 224.9 x 5.00
