Labs-Aetheron/Novexa/Mechanical/Design/All STLS/2SBatteryHolder.stl

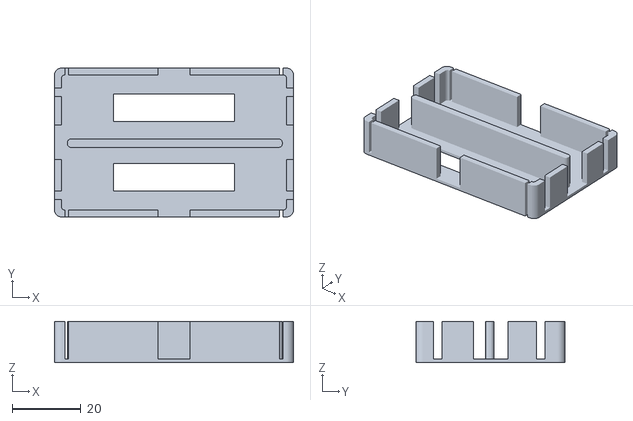
[picture p68: CAD file, 2025-12-05]
Mechanical/Design/All STLS/2SBatteryHolder.stl
69.4 x 43.2 x 12.0
