Labs-Aetheron/Novexa/Mechanical/Design/All STLS/CoxaHornConnectorV2.stl

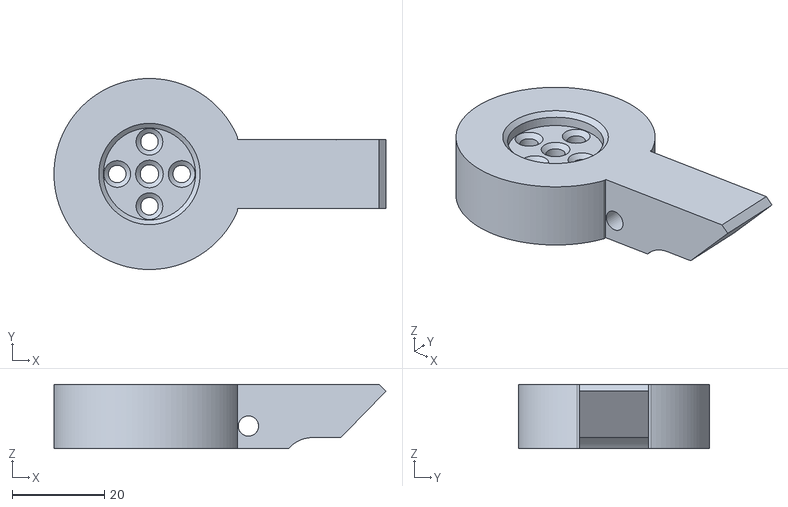
[picture p69: CAD file, 2025-12-05]
Mechanical/Design/All STLS/CoxaHornConnectorV2.stl
72.1 x 41.5 x 14.0
