Labs-Aetheron/Novexa/Mechanical/Design/All STLS/BearingMountV2.3mf

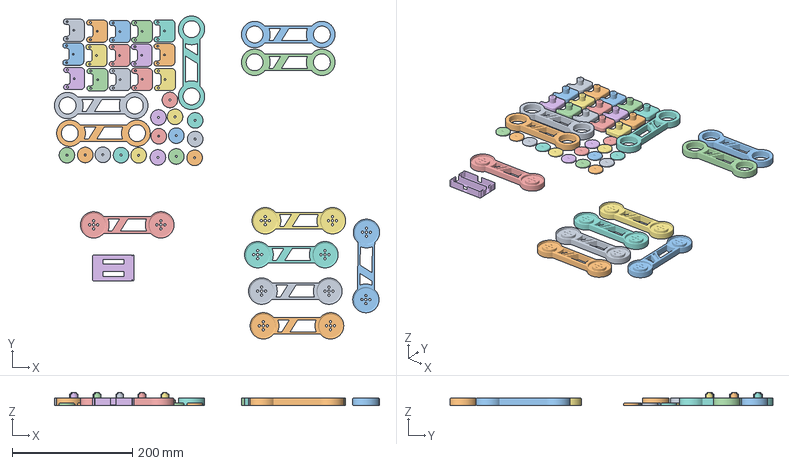
[picture p70: CAD file, 2025-12-05]
Mechanical/Design/All STLS/BearingMountV2.3mf
541.4 x 537.7 x 21.4 mm
BearingMountV2.stl x 15
FemurBearingSideV2.stl x 5
FemurHornSideV2.stl x 6
2SBatteryHolder.stl
Hubcap.stl x 15
