Labs-Aetheron/Novexa/Mechanical/Design/All STLS/CoxaHornV2.stl

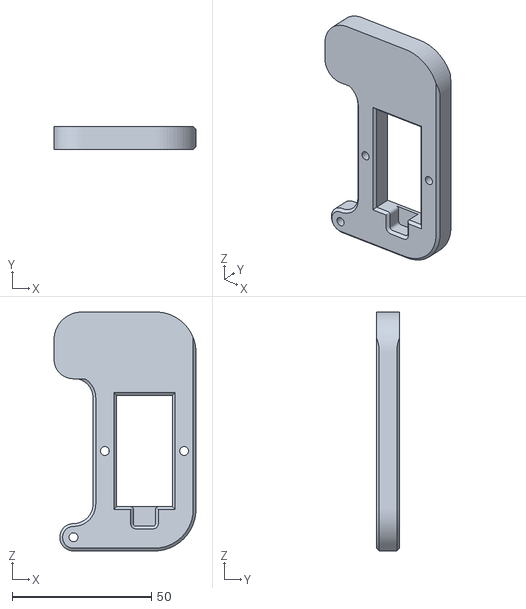
[picture p71: CAD file, 2025-12-05]
Mechanical/Design/All STLS/CoxaHornV2.stl
51.0 x 8.30 x 85.9
