Labs-Aetheron/Novexa/Mechanical/Design/All STLS/FemurHornSideV2.stl

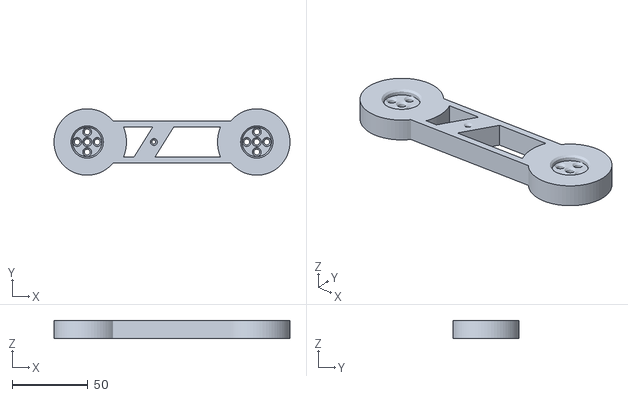
[picture p72: CAD file, 2025-12-05]
Mechanical/Design/All STLS/FemurHornSideV2.stl
155.8 x 43.9 x 12.0
