Labs-Aetheron/Novexa/(list of files, cad)

Other CAD files:
Mechanical/Design/Cad/BearingMountV2.3mf
Mechanical/Design/All STLS/FemurBearingSideV2.stl
Mechanical/Design/All STLS/2M12mm Screw.stl
Mechanical/Design/All STLS/2M24mm Screw.stl
Mechanical/Design/All STLS/2_3M24mm Screw.stl
Mechanical/Design/All STLS/BearingMountV2.stl
Mechanical/Design/All STLS/CoxaHornConnectorV2.f3d
Mechanical/Design/All STLS/MiddlePlateV2.f3d
Mechanical/Design/All STLS/MiddleTopPlate.f3d
Mechanical/Design/Assembly/novexa_assembly_02.f3d
Mechanical/Design/Body/BodyWithArms.f3z
Mechanical/Design/Body/BottomPlateV2.f3d
Mechanical/Design/Cad/BearingMountV2.stl
