Labs-Aetheron/Novexa/(commit log)

2026-08-24 Revise README to include comprehensive project details
    Expanded the README to provide detailed information about Novexa, including its features, specifications, kinematics, gait planning, electronics architecture, and future development plans.
2026-10-25 MujoCo and render scripts
    [novexa_assembly_01.step, novexa_assembly_02.f3d]
